joeroback/racechrono-canbus/docs/CANbusHacking.md

# CAN-bus Hacking with Raspberry Pi

TODO
