joeroback/racechrono-canbus/docs/WiringVehicles.md

# Vehicles Supported

## BMW F/G Series

Making the physical connection to the PT (Power Train) CAN-bus on a BMW G8x series vehicle is not too difficult.
The CAN seems to be the same on all F and G series BMWs, as well as J series Toyotas, using the BMW engines.

It requires...

* [Posi-tap Connectors, 20-22 Gauge Wire](https://smile.amazon.com/dp/B004D0C2RC)
* [22 awg JST SM 2 Pin Plugs](https://smile.amazon.com/dp/B06WGN56V2)
* [1/8 inch Cord Protector Wire Loom Tubing](https://smile.amazon.com/dp/B07FWCJ7QF)
* [Heat Shrink Tubing](https://smile.amazon.com/dp/B084GDLSCK)

PT-CAN is located in the passenger side footwell. Using some basic plastic pry tools, you can expose the wiring harnesses.
CAN-bus wires are always twisted pairs, making them easy to identify. In the case of the BMW G8x series, CAN+ (High) is
Yellow/White and CAN- (Low) is Yellow/Black. Using Posi-tap Connectors so that the wiring harness does not have to
disassembled, making sure to twist the wires. Heat shrink and wire loom to protect wire and have a very clean install.

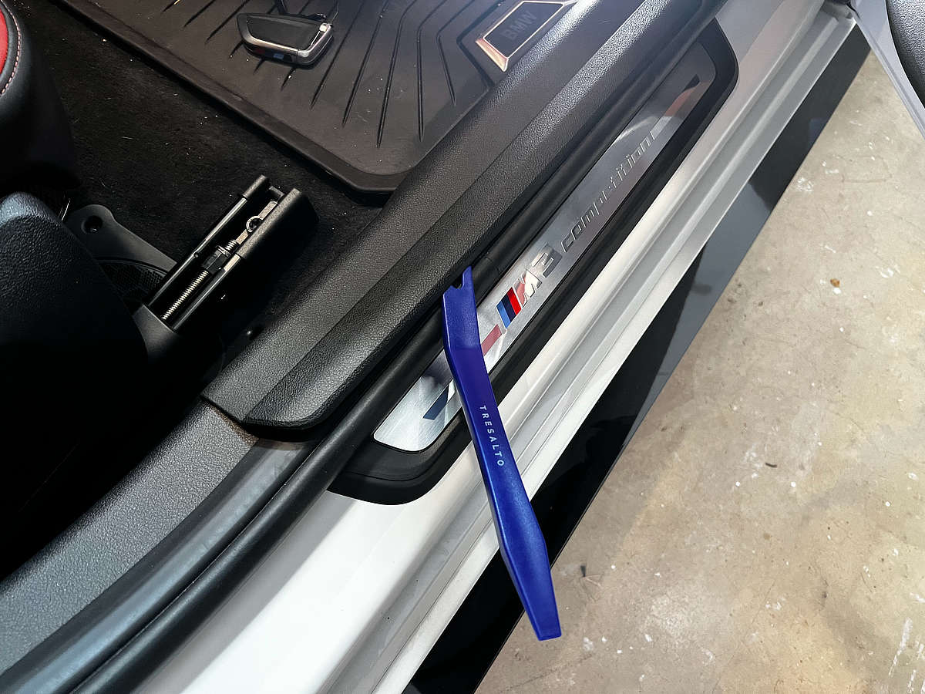
[picture p2: docs/images/bmwg8x/IMG_5538.jpg]


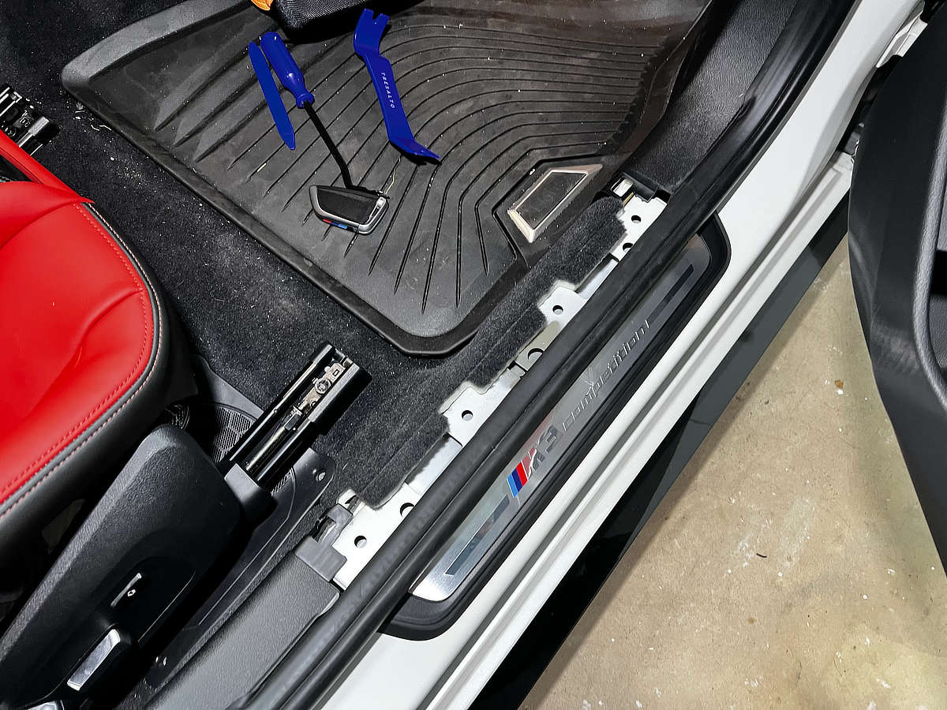
[picture p3: docs/images/bmwg8x/IMG_5539.jpg]


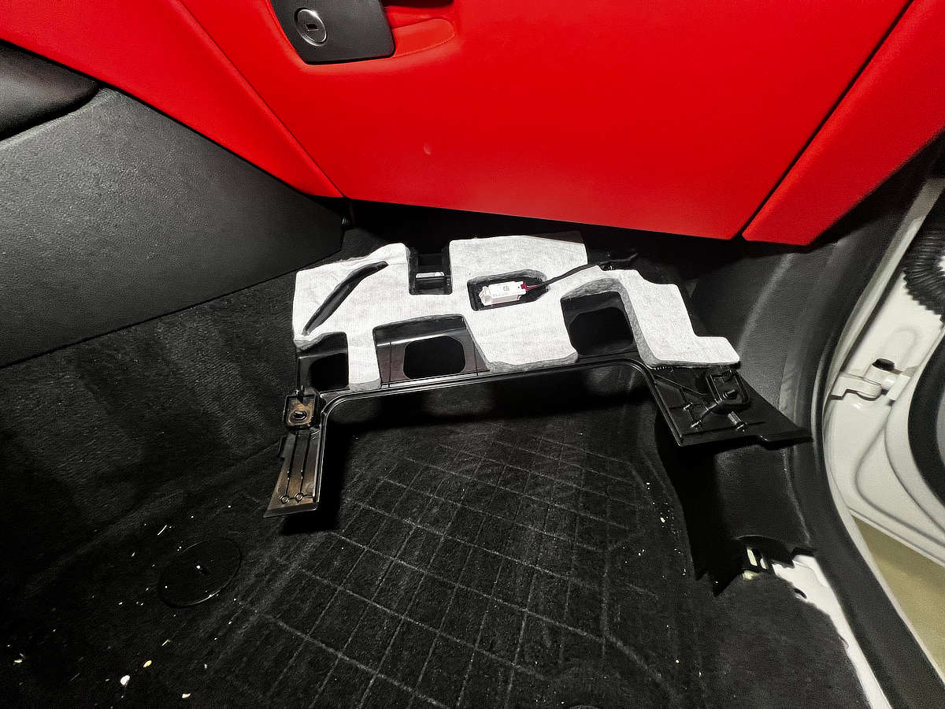
[picture p4: docs/images/bmwg8x/IMG_5542.jpg]


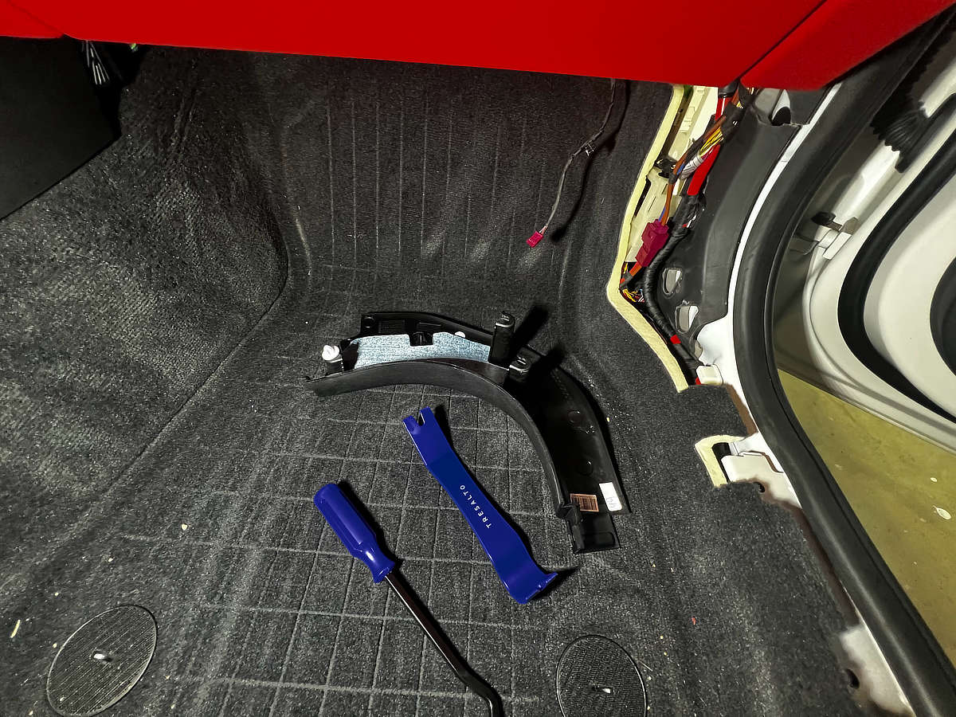
[picture p5: docs/images/bmwg8x/IMG_5543.jpg]


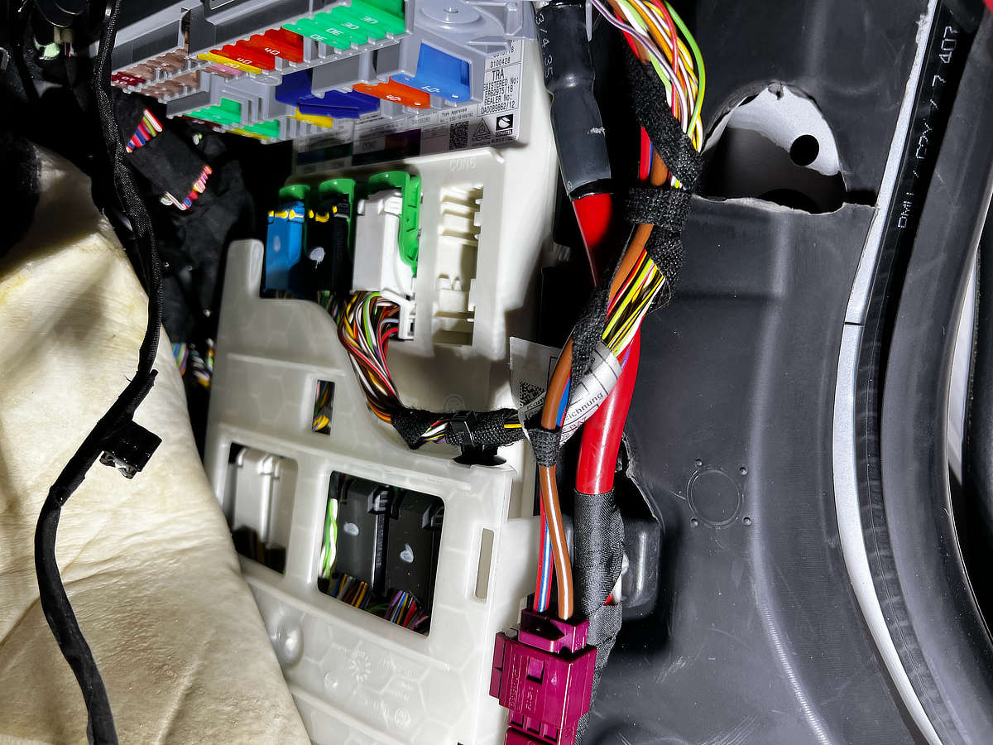
[picture p6: docs/images/bmwg8x/IMG_5545.jpg]


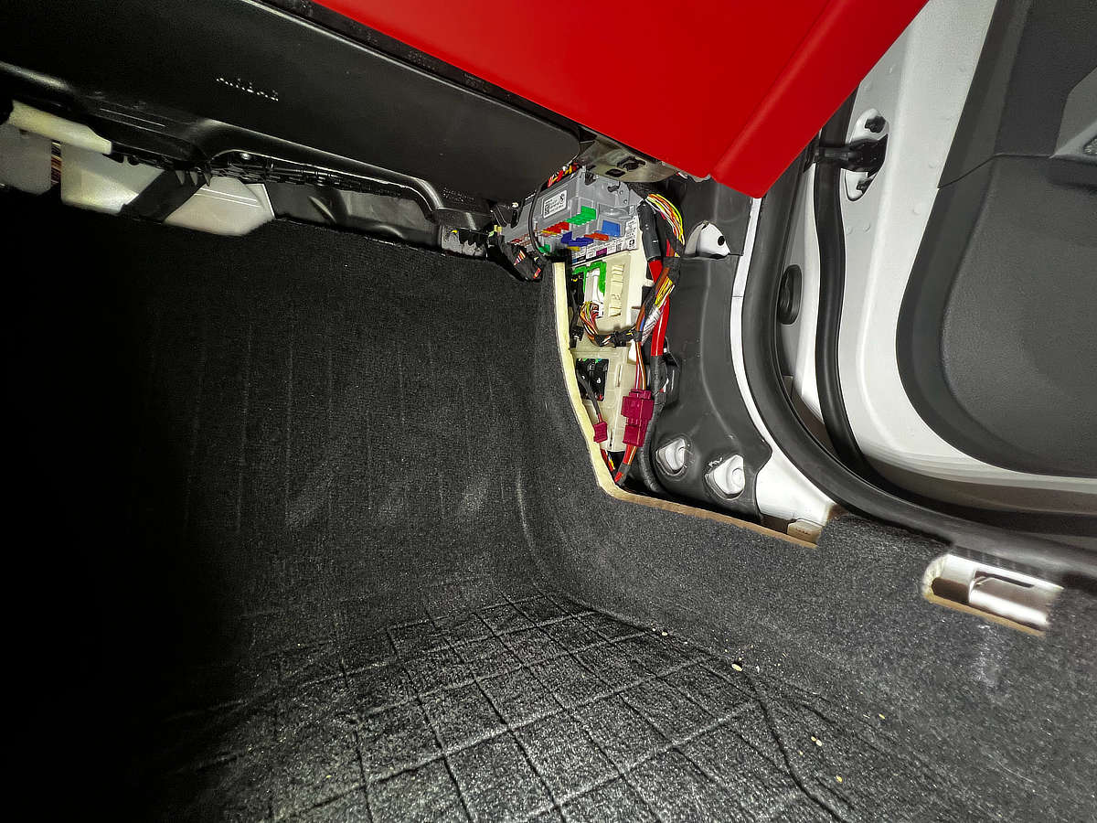
[picture p7: docs/images/bmwg8x/IMG_5546.jpg]


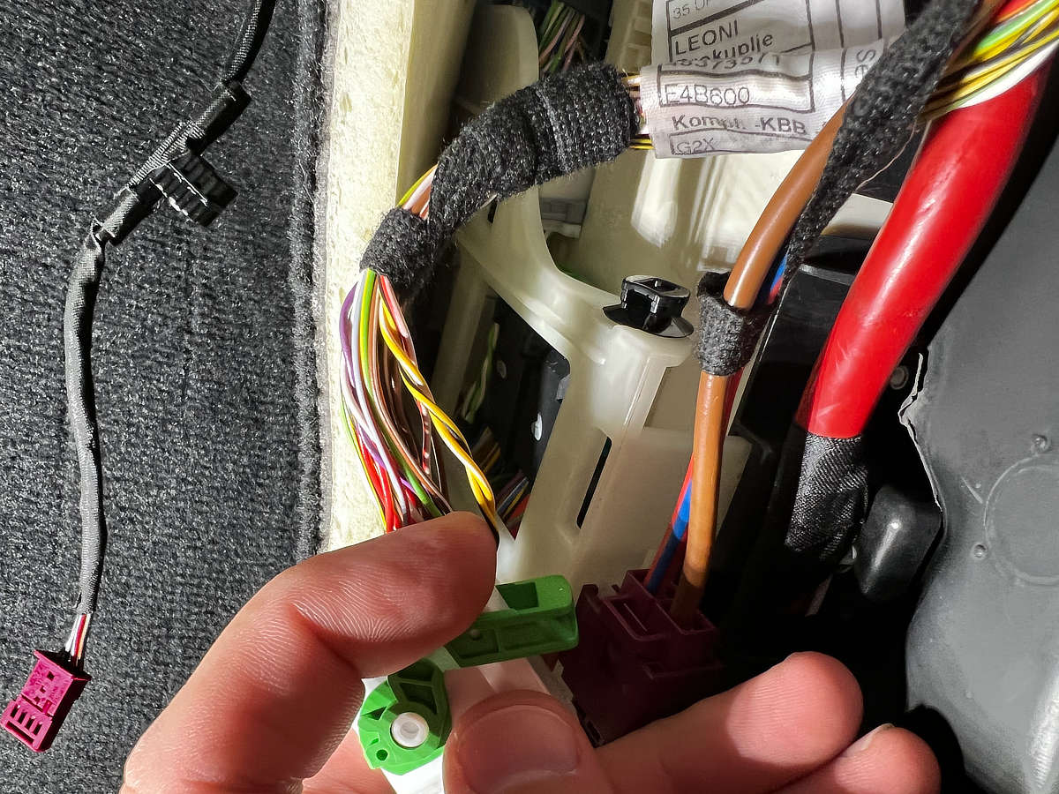
[picture p8: docs/images/bmwg8x/IMG_5553.jpg]


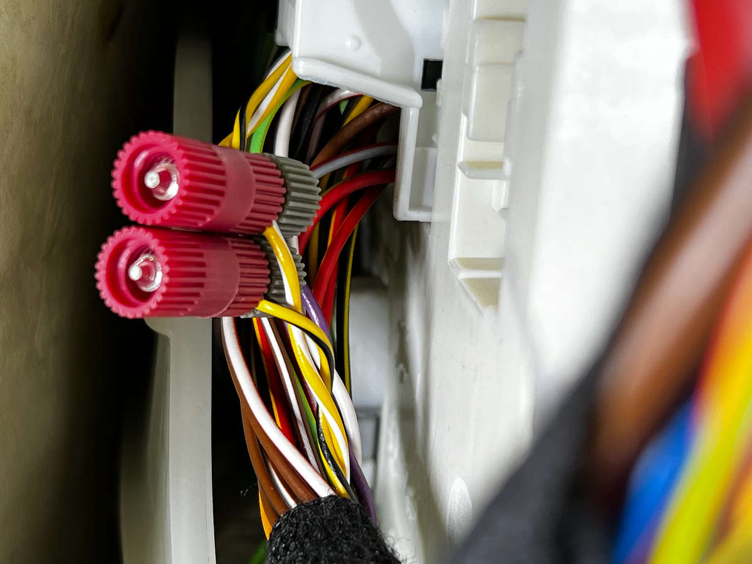
[picture p9: docs/images/bmwg8x/IMG_5554.jpg]


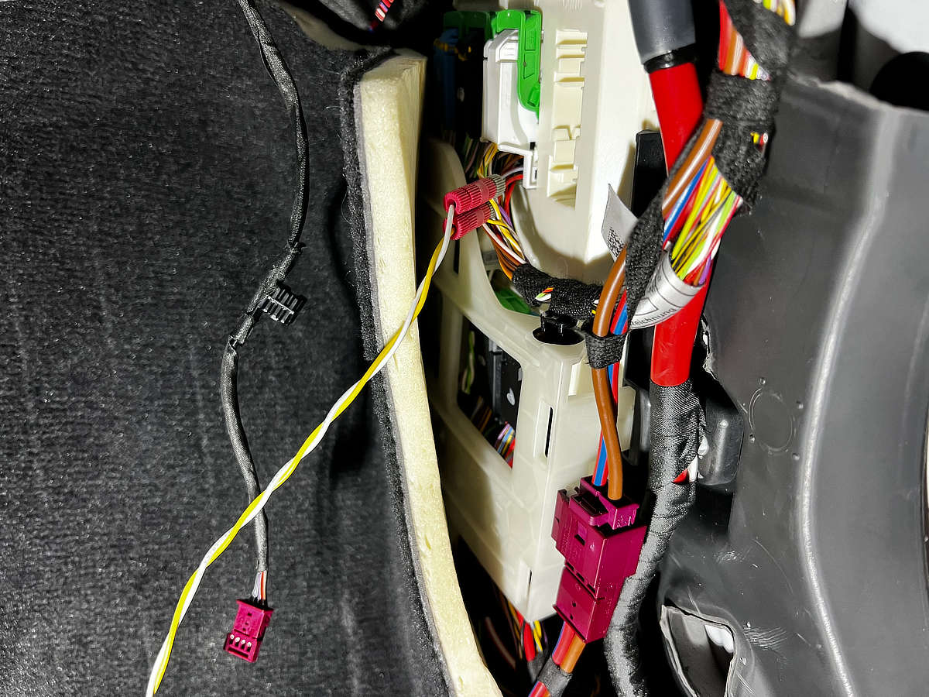
[picture p10: docs/images/bmwg8x/IMG_5555.jpg]


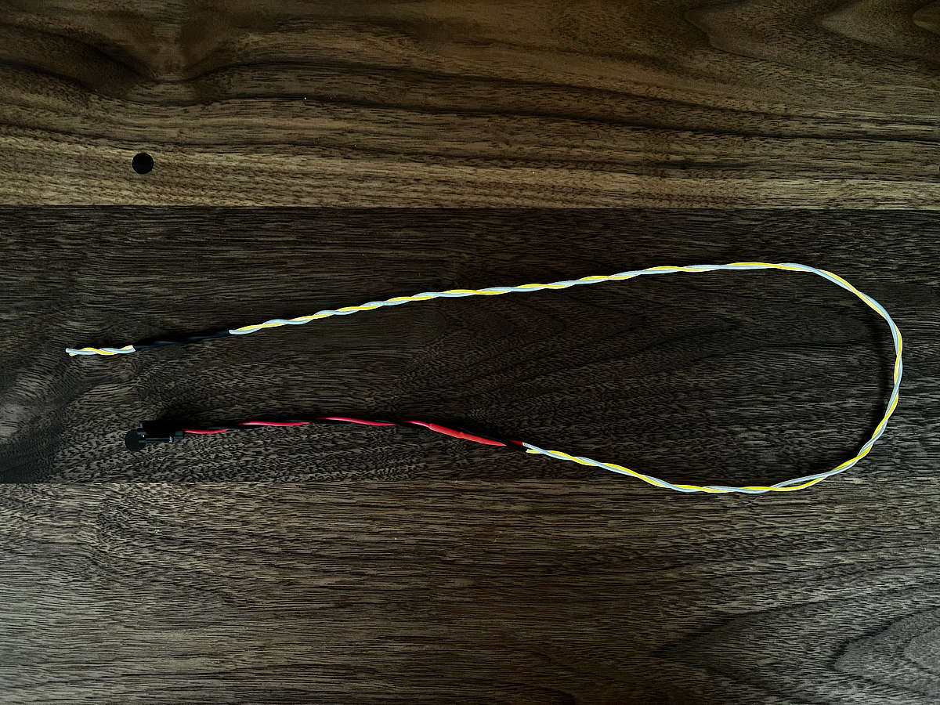
[picture p11: docs/images/bmwg8x/IMG_5565.jpg]


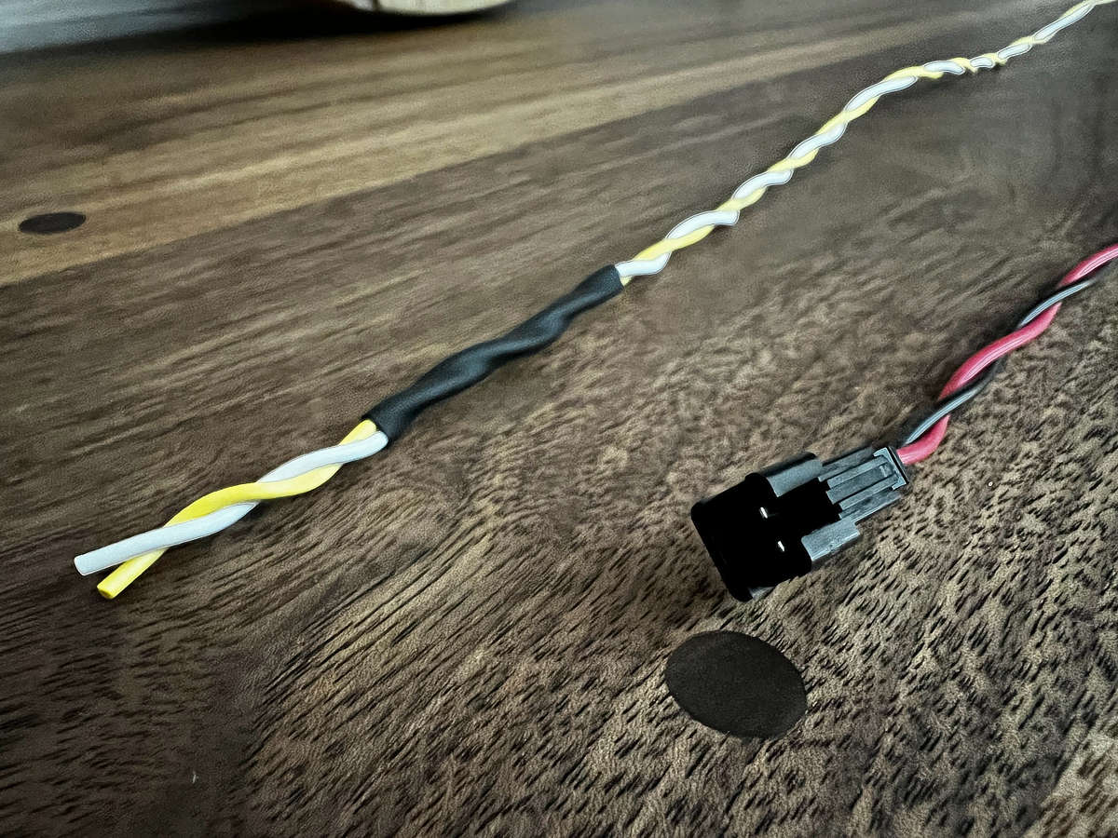
[picture p12: docs/images/bmwg8x/IMG_5566.jpg]


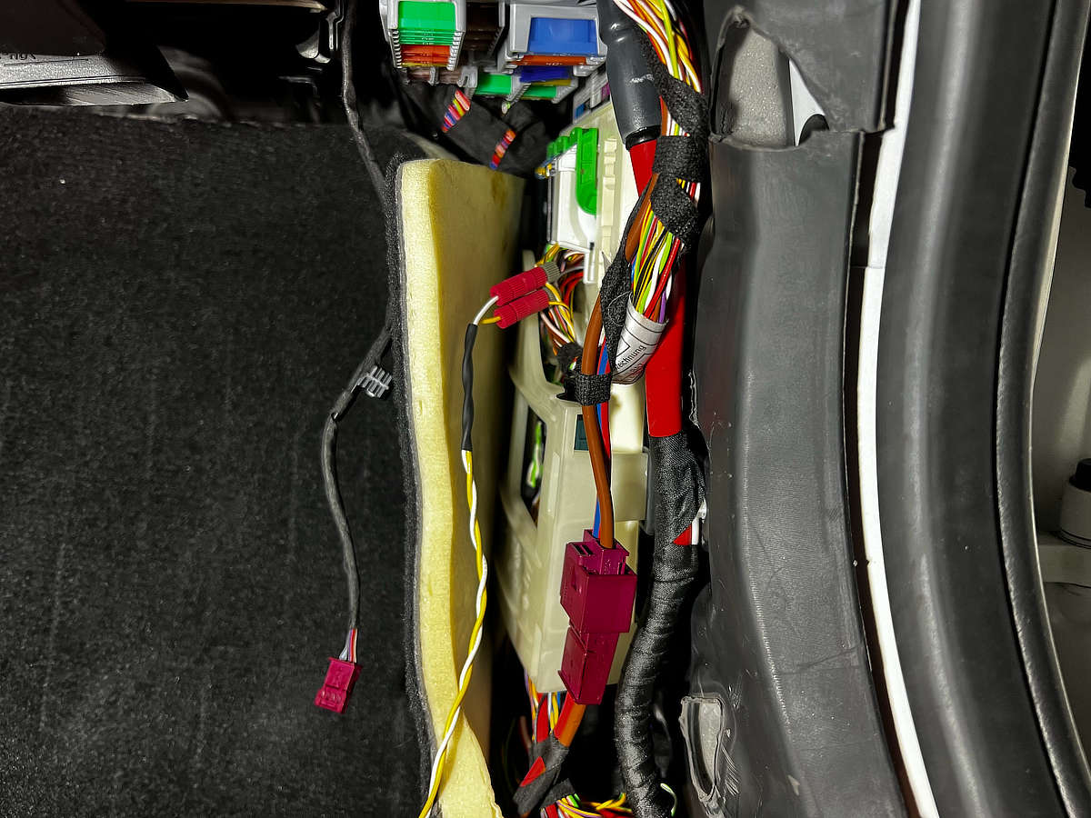
[picture p13: docs/images/bmwg8x/IMG_5571.jpg]


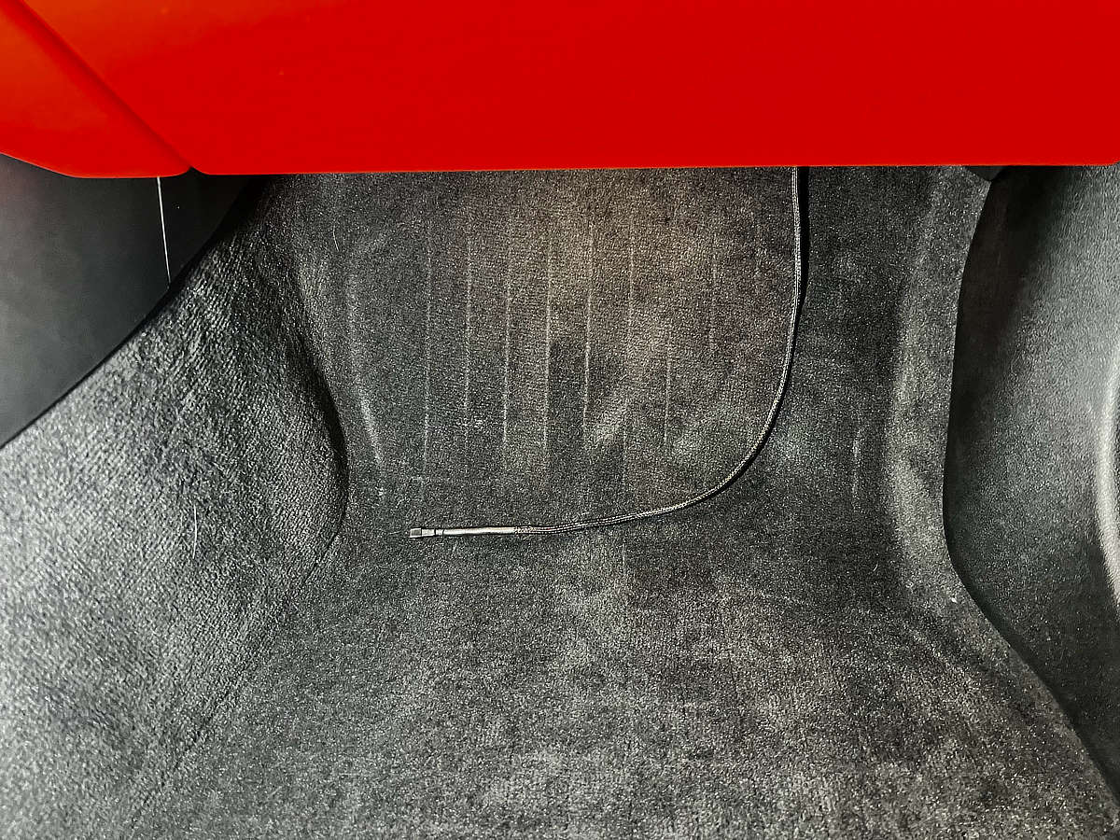
[picture p14: docs/images/bmwg8x/IMG_5574.jpg]


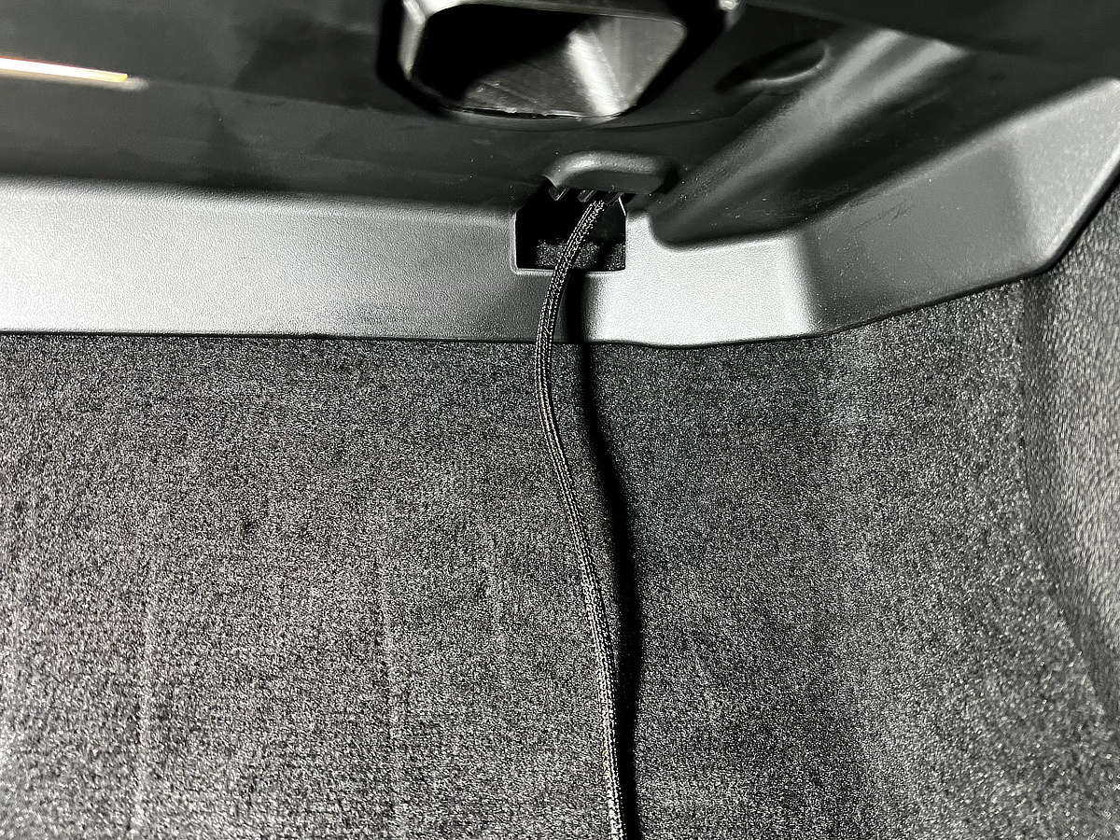
[picture p15: docs/images/bmwg8x/IMG_5575.jpg]


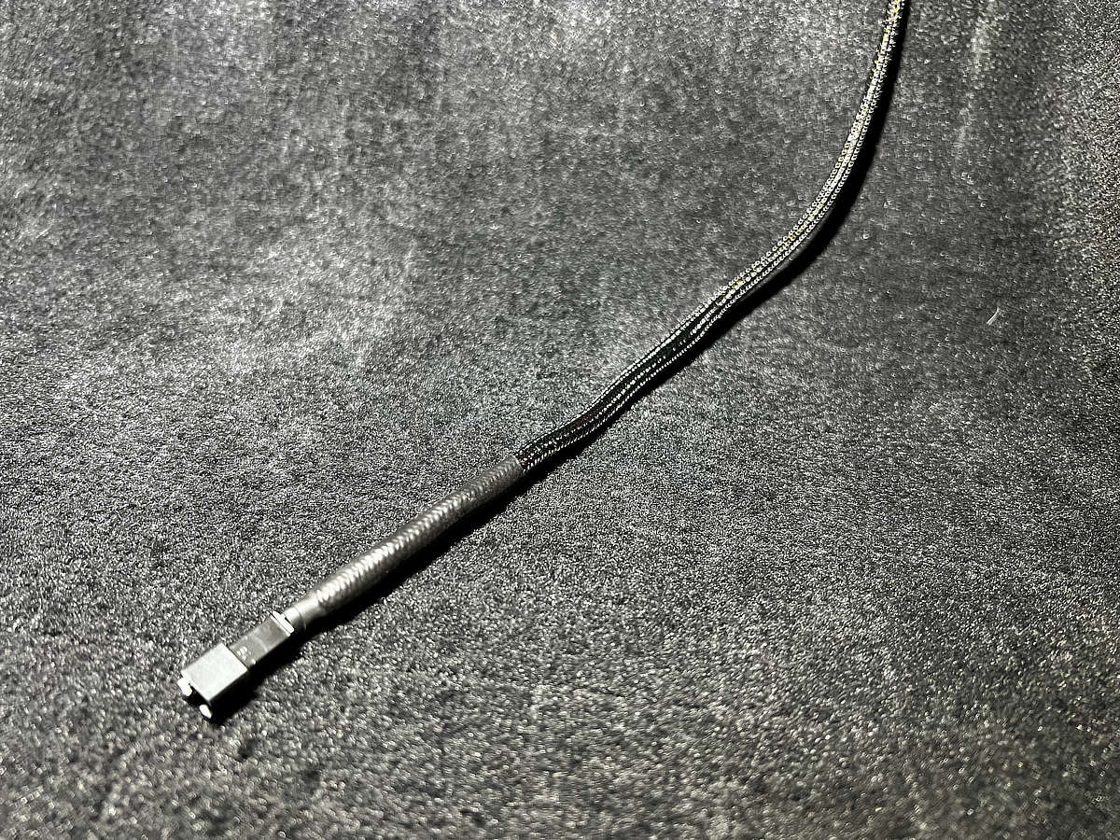
[picture p16: docs/images/bmwg8x/IMG_5576.jpg]
