joeroback/racechrono-canbus/(threads)

Thread 1 (2023-09-26):

looks the same as the G29 codes

webr3, 2023-09-26:
the main point, you may find this useful - stumbled on this whilst researching somebody else doing the same but with G29/J29 and feeding racecapture
- https://thesecretingredient.neocities.org/bmw/can/g29/
- credit to user on github https://github.com/jcevanco

I've been reading your posts over the web, to basically try and do the same and gather some metrics for track use, going to start getting a working setup on my daily g01, then on to an F20 b58 after I acquire one in the spring - think I'll go with a CSS Electronics CL2000 + their passive crocodile clip to start getting data out, then use the same approach as you.

discussion: how are you finding racechrono? it looks great, but I'm already frustrated by the requirement of BLE rather than a usb driver or enet straight in to a device, struggling to find an alternative for real time rather than post analysis (where we can just transform data) - right now I know I'll be comfortable doing the transformations, decode and recode in to any media type, but which software to ultimately use to review gps+camera+throttle/brake/steering etc is throwing me a bit, they're all very closed, unless you can enlighten or suggest?

joeroback, 2023-09-26:
on interesting on https://thesecretingredient.neocities.org/bmw/can/g29/ .. there are a few in there i don't have and i have a few not listed.

My list: https://docs.google.com/spreadsheets/d/1O491j8jlEOYR6voFPAYZ2NpbNyCKAgqbxt4HVw0bSDA/edit#gid=1239910575

that being said, i sold my g80 and purchased a 992 GT3, thus https://github.com/joeroback/racechrono-canbus/tree/992_GT3

---

i really like racechrono, tho porsche's track precision app also seems great and somehow porsche is allowed on carplay, unlike racechrono, as apple's carplay terms of use explicitly has displaying real-time telemetry or car data is not allowed... if racechrono could be on carplay showing the deltas on the built-in screen like porsche, that would be amazing.

i haven't really found BLE to be an issue data at 50hz or less with newer iPhones and ESP32-S3 (dual core, so i dedicate one core to BLE stack). BLE is also what racebox mini uses, and i like that BLE is connectionless, so i find at the track and i can get in and out of the car and each time i get back in and go, things just work, don't have to fuss with the bluetooth settings and try and keep things "connected"

my setup is basically, iphone, racebox mini (25hz gps), esp32-s3 (can-bus), OBDLink MX+, gopro hero10+ and i find that racechrono manages all of this pretty gracefully, because i dont want to spend time with stupid tech while i am trying to drive.

i was using the MX+ for some fuel and oil/coolant temps, etc, i didn't have, but those are now listed on https://thesecretingredient.neocities.org/bmw/can/g29/ :)

afterwards, if i want to analyze laps, i just airdrop sessions from iphone to ipad pro and have a nice large screen go through laps. i have tried using AIM stuff, like RaceStudio3 and its definitely more pro, but i am not a pro and i find racechrono is a good balance between ease of use and information.

---

TrackAddict was a WiFi based standard, which is interesting, but i find that TrackAddict and RaceRender products are EOL and haven't been updated in years.

Numeric Broadcast Protocol (NBP) Devices: https://racerender.com/TrackAddict/docs/Interop.html#NBP

which is similar to RaceChrono's DIY BLE concept

joeroback, 2023-09-26:
if i was doing any OBD2 stuff again, i would probably go with the Kiwi3, as its BLE as well, the MX+ is regular bluetooth and you do have to fuss with it connecting sometimes.

for both the g80 and gt3, i just used posi-tap connectors, contactless was appealing, but saw too many posts of contactless stuff losing connection, so posi-tap stuff was good middle ground, solid connection and i didn't have to mess with any wiring harnesses, etc.

https://www.amazon.com/gp/product/B004D0C2RC/

joeroback, 2023-09-26:
for testing, i was using a raspberry pi4 + can hat + anker battery to use can-utils and candump for logging and later offline decoding of PIDs

https://photos.app.goo.gl/pTZU7J7taPfTp4q6A

i covered the wire in a black nylon sleeve and had a quick disconnect to go from pi4 to esp32 depending if i was debugging/decoding or at the track

joeroback, 2023-09-27:
hrm, i don't remember, it was mainly around the Racelogic VBOX, which has an induction option on the porsche forums (rennlist.com) .. it seemed hit or miss. the other thing with the induction, you need to have a decent run of the twisted pair untwisted to get it in the induction case, which usually means you have to pull the wires out of the harness to untwist and i didn't want to do that, posi-tap can sneak in easily IMO.

992 GT3, very similar CAN connection in passenger footwell like G80:
https://share.icloud.com/photos/00fneWRfEROZ56_T70gzRw6pg

joeroback, 2023-09-27:
oh i didn't realize kiwi products were discontinued.. well my experience with OBDII was < 3hz once you add 3 or 4 items, so with that list you posted here, there is nothing unique to OBDII data, its all available on can bus, at least for F/G series BMW and equivalent toyotas.

in any case, i am still having issues getting any data from the 992, even though it seems plenty of ppl using VBOX on rennlist with the same CAN bus wires.. will need a weekend or more to really debug. lol

joeroback, 2023-10-02:
added support for extra PIDs from https://thesecretingredient.neocities.org/bmw/can/g29/ in https://github.com/joeroback/racechrono-canbus/commit/db9a3d0ac0cd22e483c185296464cb4d84b81210

Closed 2023-10-02.

Thread 2 (2023-10-08):

Hello, I tried your codes on a esp32-s3 dev module, this came from the serial port, any idea what's wong?

RayDutchman, 2023-10-08:
Starting up on core 1
Bluetooth LE starting...
Bluetooth LE MAC: 34:85:18:bc:fd:29

Bluetooth LE started!

Guru Meditation Error: Core  1 panic'ed (Interrupt wdt timeout on CPU1).

Core  1 register dump:
PC      : 0x403821d5  PS      : 0x00060a34  A0      : 0x8037f26f  A1      : 0x3fcebe00
A2      : 0x00000002  A3      : 0x3fc9d800  A4      : 0x00000004  A5      : 0x00060a23
A6      : 0x00060a23  A7      : 0x00000001  A8      : 0x00000001  A9      : 0x00000001
A10     : 0x00000001  A11     : 0x00001023  A12     : 0x0000101f  A13     : 0x00060a23
A14     : 0x02cec5f0  A15     : 0x00ffffff  SAR
 : 0x00000018  EXCCAUSE: 0x00000006
EXCVADDR: 0x00000000  LBEG    : 0x40056f5c  LEND    : 0x40056f72  LCOUNT  : 0xffffffff

Backtrace: 0x403821d2:0x3fcebe00 0x4037f26c:0x3fcebe40 0x42009829:0x3fcebe70 0x42003331:0x3fcebea0 0x4200336d:0x3fcebf50 0x42003045:0x3fcec030 0x42009f7a:0x3fcec060

Core  0 register dump:
PC      : 0x420928ae  PS      : 0x00060834  A0      : 0x82010940  A1      : 0x3fcf4730
A2      : 0x00000000  A3      : 0x4207c21c  A4      : 0x00060120  A5      : 0x80000000
A6
   : 0x02c98320  A7      : 0x00ffffff  A8      : 0x8201047a  A9      : 0x3fcf4700
A10     : 0x00000000  A11     : 0x3fc98310  A12     : 0x3fc98310  A13     : 0x00000000
A14     : 0x00060120  A15     : 0x00000000  SAR     : 0x0000001d  EXCCAUSE: 0x00000006
EXCVADDR: 0x00000000  LBEG    : 0x00000000  LEND    : 0x00000000  LCOUNT  : 0x00000000

Backtrace: 0x420928ab:0x3fcf4730 0x4201093d:0x3fcf4750 0x40380728:0x3fcf4770

ELF file SHA256: 50a3a0a7f18cc6b4

Guru Meditation Error: Core  1
 panic'ed (Interrupt wdt timeout on CPU1).

Core  1 register dump:
PC      : 0x40386ae3  PS      : 0x00020534  A0      : 0x8206f96a  A1      : 0x3fcebc10
A2      : 0x00020523  A3      : 0xa5a5a5a5  A4      : 0x8206f96a  A5      : 0x00060525
A6      : 0xfffbfff0  A7      : 0x00000046  A8      : 0x3fc98c34  A9      : 0x00000001
A10     : 0x60000000  A11     : 0x00000001  A12     : 0x0000000a  A13     : 0x3fcebbfc
A14     : 0x00000001  A15     : 0x3fcf4770  SAR     : 0x0000000a  EXCCAUSE: 0x000
00006
EXCVADDR: 0x00000000  LBEG    : 0x400570e8  LEND    : 0x400570f3  LCOUNT  : 0x00000000

Backtrace: 0x40386ae0:0x3fcebc10 0x4206f967:0x3fcebc20 0x4206ff69:0x3fcebc40 0x42010e1a:0x3fcebc60 0x4201110e:0x3fcebcd0 0x40377331:0x3fcebd20 0x40376cc0:0x3fcebd40 0x00040022:0x3fcebe00 |<-CORRUPTED

Core  0 register dump:
PC      : 0x420928ae  PS      : 0x00060834  A0      : 0x82010940  A1      : 0x3fcf4730
A2      : 0x00000000  A3      : 0x4207c21c  A4      : 0x00060120  A5      : 0x80000000

A6      : 0x02c98320  A7      : 0x00ffffff  A8      : 0x8201047a  A9      : 0x3fcf4700
A10     : 0x00000000  A11     : 0x3fc98310  A12     : 0x3fc98310  A13     : 0x00000000
A14     : 0x00060120  A15     : 0x00000000  SAR     : 0x0000001d  EXCCAUSE: 0x00000006
EXCVADDR: 0x00000000  LBEG    : 0x00000000  LEND    : 0x00000000  LCOUNT  : 0x00000000

Backtrace: 0x420928ab:0x3fcf4730 0x4201093d:0x3fcf4750 0x40380728:0x3fcf4770

ELF file SHA256: 50a3a0a7f18cc6b4

Re-entered core dump! Exc
eption happened during core dump!
Rebooting...
ESP-ROM:esp32s3-20210327
Build:Mar 27 2021
rst:0xc (RTC_SW_CPU_RST),boot:0x2a (SPI_FAST_FLASH_BOOT)
Saved PC:0x4201101a
SPIWP:0xee
mode:DIO, clock div:1
load:0x3fce3808,len:0x44c
load:0x403c9700,len:0xbe4
load:0x403cc700,len:0x2a68
entry 0x403c98d4

joeroback, 2023-10-09:
hrm, could it be your core settings?

https://github.com/joeroback/racechrono-canbus/blob/trunk/docs/Arduino.md

its important both settings are set to core 1, all the can bus interrupts need to run on core 1, and all the bluetooth interrupts and callbacks need to run on core 0 (the arduino default for BLE is core 0)?

--

it could possibly be my latest changes for BMW codes, you could try reverting to the previous commit, https://github.com/joeroback/racechrono-canbus/commit/ef1d9c22a980c49ff87cc0c17591966e93dd0b6a

i was adding those new BMW codes, but at the same time trying to bootstrap porsche 992 support, so maybe i broke something unintentionally

Thread 3 (2023-10-27):

Raw CAN logs

superwofy, 2023-10-27:
Hello Joe,

Is there any chance you could attach any raw CAN logs you may have collected while developing this?
I am working on implementing the CRC on acceleration messages 0x199, 0x19A...

Thank you.

joeroback, 2023-10-27:
unfortunately i do not have any CAN logs collected while in motion. i probably do have a RaceChrono session with those values, it should have acceleration messages from iPhone, Racebox Mini, and CAN, so you should be able to even compare them. i'll have to look this weekend for them, as they would be on a spare phone i only use for the track that i do not have with me at the moment

joeroback, 2023-10-28:
[session_20230718_120003_hpr_full_lap4_v3.csv](https://github.com/joeroback/racechrono-canbus/files/13196087/session_20230718_120003_hpr_full_lap4_v3.csv)

superwofy, 2023-10-28:
Thank you!

Closed 2023-10-28.

Thread 5 (2023-12-13):

Transmitting messages

dn00, 2023-12-13:
Hey this is some beautiful code. This is my first Arduino project so please bare with me. I'm trying to set up the controller so that it would be able to transmit messages as well. The issue is that the RX interrupt is never triggered after I load a frame and transmit with `twai_ll_set_cmd_self_rx_request()`. Here are the changes I've made:

1. Set mode to `TWAI_MODE_NO_ACK`. I currently only have one board to play around with so I can't connect another node yet.
2. Set the TX pin
```c
    gpio_set_pull_mode(CAN_TX_PIN, GPIO_FLOATING);
    esp_rom_gpio_connect_out_signal(CAN_TX_PIN, TWAI_TX_IDX, false, false);
    esp_rom_gpio_pad_select_gpio(CAN_TX_PIN);
    gpio_set_direction(CAN_TX_PIN, GPIO_MODE_OUTPUT);
```
3. In my send method, I load a message frame with `twai_ll_set_tx_buffer(dev, &tx_buffer)` then call `twai_ll_set_cmd_tx(dev)` or `twai_ll_set_cmd_self_rx_request(dev)` but neither triggers the RX interrupt.

`twai_ll_is_last_tx_successful()` return false and `twai_ll_get_status()` returns 0x00000030.

What am I missing? My goal is to take a 0-5v input from an ethanol analyzer and send a zeitronix formatted message to bootmod3. Any help is appreciated.

dn00, 2023-12-14:
I fixed by setting GPIO differently

```c
        gpio_config_t gpio_conf;
        gpio_conf.mode = GPIO_MODE_OUTPUT;
        gpio_conf.intr_type = GPIO_INTR_DISABLE;
        gpio_conf.pull_down_en = GPIO_PULLDOWN_DISABLE;
        gpio_conf.pull_up_en = GPIO_PULLUP_DISABLE;
        gpio_conf.pin_bit_mask = 1ULL << CAN_TX_PIN;
        gpio_config(&gpio_conf);
        esp_rom_gpio_connect_out_signal(CAN_TX_PIN, TWAI_TX_IDX, false, false);
```

joeroback, 2023-12-14:
yea, i specifically didn't enable any transmit stuff, as my use-case is read-only, but it seems like you figured it out. i basically did not enable any of the TX interrupts, but the IDF twai API has good examples of doing this as well

dn00, 2023-12-14:
This is my first Arduino project so I'm kind of skipping a lot of steps beginners would want to go through before attempting something this complex 😅. However, your code is clean and organized which helps a lot. Really appreciate you sharing it.

joeroback, 2023-12-14:
one thing you might look at, i am explicitly putting the CAN transceiver in listen-only mode
`twai_ll_set_mode(dev, TWAI_MODE_LISTEN_ONLY);    // freeze REC by changing to LOM mode`

you might consider changing that to normal mode: `TWAI_MODE_NORMAL`
https://docs.espressif.com/projects/esp-idf/en/v4.3/esp32/api-reference/peripherals/twai.html#enumerations

if you are planning on sending messages on the CAN bus

dn00, 2023-12-15:
Yep I currently have it set to NO_ACK for self tests. There's a few things I need to implement before I'll test it on the car.

Closed 2023-12-14.

Thread 6 (2024-01-10):

Read driving mode

renedis, 2024-01-10:
First of all; thank you for your hard work. I've seen the post on bimmerpost and I'm pretty impressed of your hard work!

I'm in the same boat in reverse-engineering the canbus and would like to know what driving-mode is in at all times. I've kinda guessed that it's provided in canbus but can't seem to find it.

I've looked at your [Google doc](https://docs.google.com/spreadsheets/d/1O491j8jlEOYR6voFPAYZ2NpbNyCKAgqbxt4HVw0bSDA/edit#gid=1239910575) but didn't find it in there too.

Do you perhaps know the ID[hex]? Or if you can/want, help me find it?

p.s. I own a 3D-printer and can help designing a case for the unit if you give me the dimensions.
