joeroback/racechrono-canbus/(commit log)

2022-12-22 gitignores for esp 2.0.6, rust clippy warning fixes
    [main.rs]
2023-07-15 Add Adafruit ESP32 Feather (Huzzah32) support
2023-07-16 update docs, code comments, detect bluetooth mac address and include the last 3 bytes in the bluetooth le advertisement name (helps when testing multiple devices)
2023-10-02 issue 1: add new BMW PIDs from https://thesecretingredient.neocities.org/bmw/can/g29/
    [decoder_bmwg8x.cpp]
